Traumflug/ISTAtrol/documentation/ISTAtrol Features.jpeg

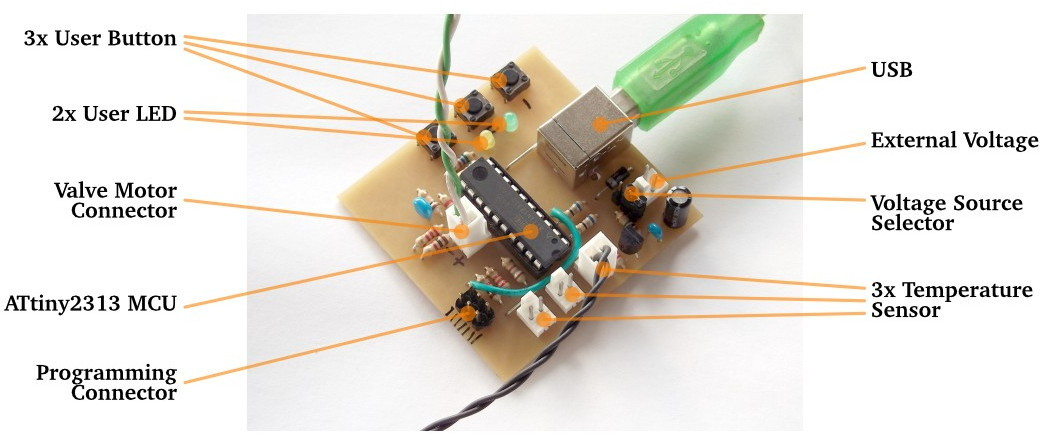
documentation/ISTAtrol Features.jpeg
