Traumflug/ISTAtrol/documentation/ISTAtrol v0.1.jpeg

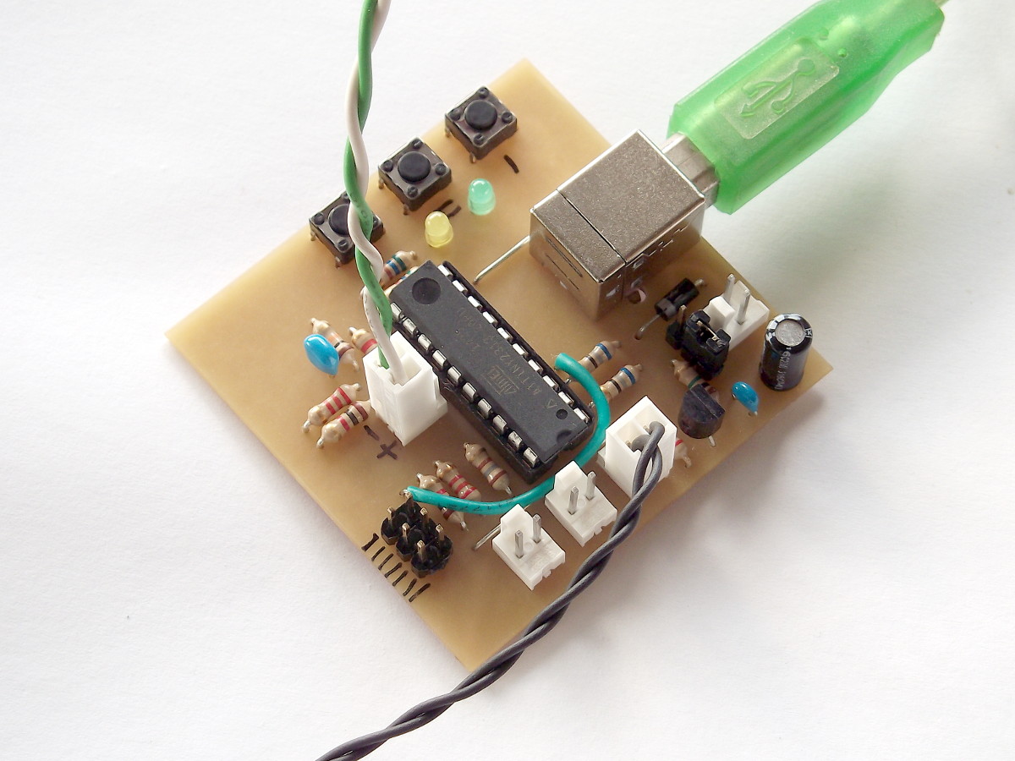
documentation/ISTAtrol v0.1.jpeg
