Traumflug/ISTAtrol/(list of files, drawings)

Other design files:
ISTAtrol.pcb
