Traumflug/ISTAtrol/terminal.py

#!/usr/bin/env python3
#
# Communications terminal for the ISTAtrol heating valve controller.
#
# Copyright (C) 2016 Markus "Traumflug" Hitter <mah@jump-ing.de>
#
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
#
# This project uses libusb and pyusb bindings for interfacing the usb bus and
# communicating with the ISTAtrol controller.
#
# Prerequisites:
#
#   sudo apt-get install python3-usb
#

import sys
import usb.core
import time

class ISTAtrolPort:
  def __init__(self, idVendor = 0x16c0, idProduct = 0x05e1):
    self.idVendor = idVendor;
    self.idProduct = idProduct;
    self.dev = None
    self.count = 0
    self.lastC = 0

  def open(self):
    self.dev = usb.core.find(idVendor = self.idVendor, idProduct = self.idProduct)
    if self.dev is None:
      sys.stderr.write("Device not found.\n")
      return

    self.dev.set_configuration()
    print (self.dev.configurations())

  def do(self):
    if self.dev is None:
      sys.stderr.write("No device open.\n")
      return

    # See https://github.com/walac/pyusb/blob/master/usb/core.py#L997
    # ctrl_transfer(self, bmRequestType, bRequest, wValue=0, wIndex=0,
    #               data_or_wLength = None, timeout = None)
    #
    # bmRequestType behaves a bit odd, not all numbers get through to the
    # peripheral. Numbers of 160 ( = 0xA0) and above usually work. Other
    # numbers may raise anexception.
    #                128 - 159 works and returns 'B'
    #                160 - 255 works and returns 'B' and 4 zeros
    #
    # data_or_wLength has to be at least as big as the number of bytes returned.
    result = self.dev.ctrl_transfer(0xC0, ord('c'), 0, 0, 10)
    readingC = result[1] * 256 + result[0]

    # Putting the value pairs recorded in Calibration measurements.gnumeric
    # into a linear regression tool like
    #   http://www.arndt-bruenner.de/mathe/scripts/regr.htm
    # we get this linear fomula:
    #
    #  f(x) = -0,00791 * x + 71,445927
    #
    # Let's take this formula to get an idea about the temperature
    # in deg Celsius:
    tempC = -0.00791 * readingC + 71.445927

    valveText = ""
    if readingC != self.lastC: # Ignore duplicates.
      if chr(result[2]) == '+':
        valveText = "  (Valve opened)"
      elif chr(result[2]) == '-':
        valveText = "  (Valve closed)"

    print("%5d\t%5d\t%2.1f°C\t%s%s" % (self.count, result[1] * 256 + result[0],
                                       tempC, time.strftime("%X"), valveText))
    self.count += 1
    self.lastC = readingC


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
dev = ISTAtrolPort()
dev.open()

while 1:
  try:
    dev.do()
  except:
    print(sys.exc_info())
    print("... trying again ...")
    time.sleep(10)
    dev.open()
    continue
  time.sleep(60)

# Done.
