Traumflug/ISTAtrol/(commit log)

2016-03-13 First draft.
    Actually it was planned to do the first commit with the first
    working board, but now the board is done and populated ... and
    bugs wre found already. So, make a commit to allow to return here
    later.
    Board was created mostly with parts from the Gen7 libraries.
    V-USB was taken from Gen7's ExtensionBoard USB-A. Some Gen7
    heritage may be still left in the sources.
    [ISTAtrol.pcb, ISTAtrol.sch]
2016-03-14 Firmware: get it compiling.
    Also copy a number of proven compiler flags over from Teacup
    firmware. Compiled binary is too big for an ATtiny2313, though.
    [main.c, usbconfig.h]
2016-03-15 Firmware: make code smaller.
    This is about as small as the code can get without disabling CDC.
    CDC is what makes the USB device a serial device.
    Unfortunately, code is still too big:
    Device: attiny2313
    Program: 2270 bytes (110.8% Full)
    Data: 79 bytes (61.7% Full)
    ... and we have zero functional code so far. This looks much like
    a universally usable serial device has to be given up.
    [main.c, usbconfig.h]
2016-03-15 Firmware: remove CDC for less binary size.
    It was replaced with a direct USB version inspired by Tobias
    Flöry's USB Dot Matrix Display:
    http://tobiscorner.floery.net/usb-dotmatrix-display/
    Now it fits into the MCU, but not exactly much left for application code:
    Program: 1938 bytes (94.6% Full)
    Data: 47 bytes (36.7% Full)
    Binary compiles flawlessly, but not tested on hardware.
    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
    [main.c, usbconfig.h]
2016-03-15 Firmware: replace osccal by osctune.
    This makes the binary quite a bit smaller, now we have some room
    to breath:
    Program: 1780 bytes (86.9% Full)
    Data: 46 bytes (35.9% Full)
    Also added some instrumentation in Makefile to analyse code size.
    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
    [main.c, usbconfig.h]
2016-03-16 Board: swap ISP voltage dividers.
    Typical beginner mistake: the 5 V signal was divided down to
    1.5 V, not 3.4 V. Swapping the 1K with the 2K2 resistors of the
    divider cures this.
    [ISTAtrol.pcb, ISTAtrol.sch]
2016-03-16 Firmware: blinking the yellow LED works!
    This means: programming fuses and a firmware works, too. One step
    closer to getting a usable controller.
2016-03-16 Board: connect D- to INT0.
    This is mandatory for osctune of V-USB to work. To get V-USB
    working at all, either of D- or D+ must be connected to a pin
    allowing an interrupt. This wasn't remembered during the initial
    design.
    [ISTAtrol.pcb, ISTAtrol.sch]
2016-03-17 Firmware: get one temperature readout working.
    So far this is a proof of concept, some details still need work:
    - Read all three sensors.
    - Optimize timer presets, timing and such stuff. Currently it's
    very slow, a measurement takes 3 seconds. Also, values are
    apparently nice for 100k thermistors, not for the 10k ones we
    want to use.
    Nevertheless, it works! Substantial advantage.
2016-03-17 Firmware: run ACD all the time and save a few bytes binary size.
    This is at the cost of unwanted interrupts. We're not busy and
    don't run on battery, so we don't care. These savings will grow
    when all three sensors are measured.
    Also added/extended a few explaining comments.
2016-03-17 Firmware: save another few bytes by running Timer 1 all the time.
2016-03-17 Firmware: add code for the other two temperature sensors.
    However, disable it right again, because the circuitry allows
    only one sensor. As soon as another one is connected, loading
    voltage drains through the turned-off sensor.
    The code for the other two sensors costs about 100 bytes, so
    we're at almost 2000 bytes already. And no motor moving so far.
2016-03-18 terminal.py: add seconds column on printout.
    This is useful for doing calibration measurements.
2016-03-18 Add calibration measurements results.
    This is very coarse, of course, but it gives an idea about
    what we're talking about.
2016-03-19 Firmware: implement valve motor movements and primitive regulation.
    This is quite a chunk, now our device should be able to do useful
    work! Binary size raised by 70 bytes, still a bit room left.
    Program: 1964 bytes (95.9% Full)
    Data: 59 bytes (46.1% Full)
    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
2016-03-19 Firmware: refine temperature regulation.
    This is, introduce predictive regulation. Because our system
    response is so incredibly slow (300 seconds dead time, almost
    an hour until a signal change stabilises), a pure PID doesn't
    work. Now we have a pure I regulator, with predictive part
    attached.
    Also added feedback to terminal.py about valve motor movements
    and refined terminal.py to give a nicer output.
    Binary size is now stuffed up to just under the roof, only
    10 bytes flash unused.
    Program: 2038 bytes (99.5% Full)
    Data: 61 bytes (47.7% Full)
    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
    [main.c, terminal.py]
2016-03-20 Firmware: don't copy USB answers around to save Flash.
    Saves a nice 20 bytes:
    Program: 2018 bytes (98.5% Full)
    Data: 55 bytes (43.0% Full)
    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
2016-03-20 Firmware: with only one sensor, don't copy it's result around.
    Saves another 8 bytes Flash:
    Program: 2010 bytes (98.1% Full)
    Data: 53 bytes (41.4% Full)
    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
2016-03-20 Firmware: replace regulation algorithm with 'full predictive'.
    This is a new model, which moves the valve on a prediction, only.
    For a detailed description, see code comments.
    The new model is even four bytes smaller:
    Program: 2006 bytes (97.9% Full)
    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
    [main.c, terminal.py]
2016-03-20 Firmware: denoise temperature with a 2-point moving average.
    We have a few bytes to spare, so let's do this. Looking at all
    ups and downs so far that's pretty cruicial.
    Costs 26 bytes Flash:
    Program: 2032 bytes (99.2% Full)
    Data: 57 bytes (44.5% Full)
    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
2016-03-21 Firmware: give up reporting temp_future to make room.
    This saves 14 bytes Flash and 3 bytes RAM. 4 bytes Flash and
    1 byte RAM of that is to not initialise the global reporting
    struct, because ' ' is a nonzero value.
    Data: 54 bytes (42.2% Full)
    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
2016-03-21 Firmware: implement 8-value moving average.
    For explanations, see http://reprap-diy.com/moving_average_on_avrs
    Unfortunately, rounding had to be commented out to save these
    4 bytes Flash to make it fit.
    We're packed up to just under the roof again:
    Program: 2046 bytes (99.9% Full)
    Data: 56 bytes (43.8% Full)
    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
2016-03-21 terminal.py: detect and don't print duplicate motor messages.
    This used to be handled in the firmware, where this can be done
    reliable, but the ATtiny2313 is filled up into the last corner
    with more important stuff, so this had to be dropped there.
    Doing the same in terminal.py might drop a message or two (if
    temperature is exactly the same between two actuations), but
    there we have plenty of space for code.
2016-03-25 Use GPLv3 license and update all the copyright notices.
    Copyright notices for the CDC-SPI project were dropped, because
    there's virtually no code from this project left.
    [ISTAtrol.sch]
