Traumflug/ISTAtrol/(notices)

Notices in the files:
firmware/pinio.h:
under the terms of the GNU General Public License as published by the Free
terminal.py:
print("Copyright (C) 2016 Markus \"Traumflug\" Hitter .")
print("for details see license.txt (GPLv3).")
